h7-v/DIYnamount/data/sm57transcrop.png

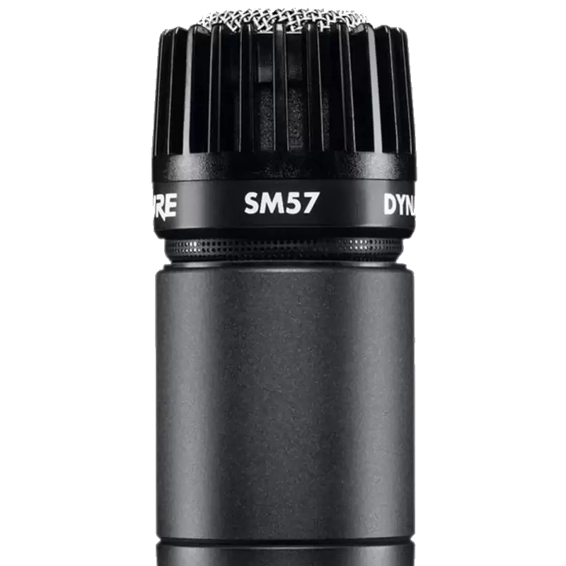
data/sm57transcrop.png
