h7-v/DIYnamount/data/vintage30.png

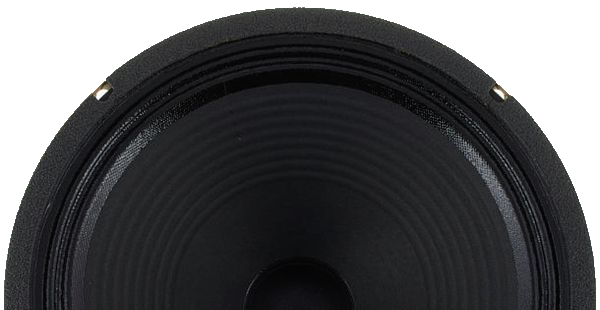
data/vintage30.png
