h7-v/DIYnamount/(threads)

Thread 1 (2025-06-06):

One of the axis doesn't move

bcochofel, 2025-06-06:
Hi, first of all, I would like to thank you for this amazing project.
I've followed the guidelines and successfully replicated this project, but I'm experiencing a peculiar issue.

On the page, I'm able to click on the move left, move right, and move closer, and make the motors work, but when I press the move further, I hear a noise, I see on the serial monitor something happening, but the motor doesn't move.
I've tried switching motors and even the drivers, but still the issue happens. I also changed the starting point from 100 to 50 and the move further workers, but the move closer doesn't. I've also tried using just the motors without any structure to see if it could be something related to the current driving the motor, but the problem still happens. All good in the left and right movement, but not in the closer and further one.

Not sure if you can help me with this, or maybe you had some type of problem like this, but any help would be appreciated

Thanks,
Bruno

h7-v, 2025-06-08:
Hi Bruno,
Thanks for checking it out and having a go! The only issue that I encountered when building one the first time round was tightening the timing gear too close to the motor which kind of locked and jammed it in place. After adjusting that I was fine. That obviously doesn't sound like your problem however.

Both motors move based on the exactly same code, albeit their starting positions in software are different. One other person who built this seems to have had a similar issue to you, although they didn't press further after mentioning it leading me to believe they might have solved it? I'll send them a message.

If the starting position of the mic is at its closest to the speaker, your first statement about pressing move further, hearing a noise but not seeing any movement points to move closer and further being physically flipped for your setup. I presume you've tried moving the mic starting position to somewhere in the middle between furthest and closest and then trying closer and further. In fact if you're saying that the issue persists even after removing the motors entirely then perhaps this is irrelevant.

Stepper motor drivers that have their DIR pins at a floating or indeterminate voltage can apparently lead to mechanical noise when the step pin is triggered (although I don't have my stand here to test at home). Sort of like they're trying to move but they don't really know in which direction, and although you also say that you've tried switching the drivers to no avail, have you tried switching GPIO pins coming from the ESP32? Trusting you've triple checked all your wiring, if switching the drivers on your breadboard etc leads to the same issue regardless of which driver, that may point to a GPIO issue on the ESP32.

I wish this was a software issue that I could just fix and you'd be on your way but I'm convinced it's either a hardware issue, or there's something about the ESP32 dev board that you and this other person are using that doesn't quite line up with what I built this with. There are lots of different variations of these boards out there from a whole bunch of different manufacturers and perhaps I ended up with some super niche board or something.

Let me know how you get on with trying some different GPIO pins, and I'll try and respond asap. It would be really good to have this solved!

h7

bcochofel, 2025-06-08:
Hi, thanks for the quick answer. I've tried most of the things you mentioned, but I haven't tried using another GPIO. Will do that and let you know.

Thanks,
Bruno

bcochofel, 2025-06-08:
Hi, quick update, just changed the ESP32 and it's working :-)

Thank you for the help, it was probably something regarding GPIO, as you said.

Bruno

Closed 2025-06-08.
