h7-v/DIYnamount/images/esp32.JPG

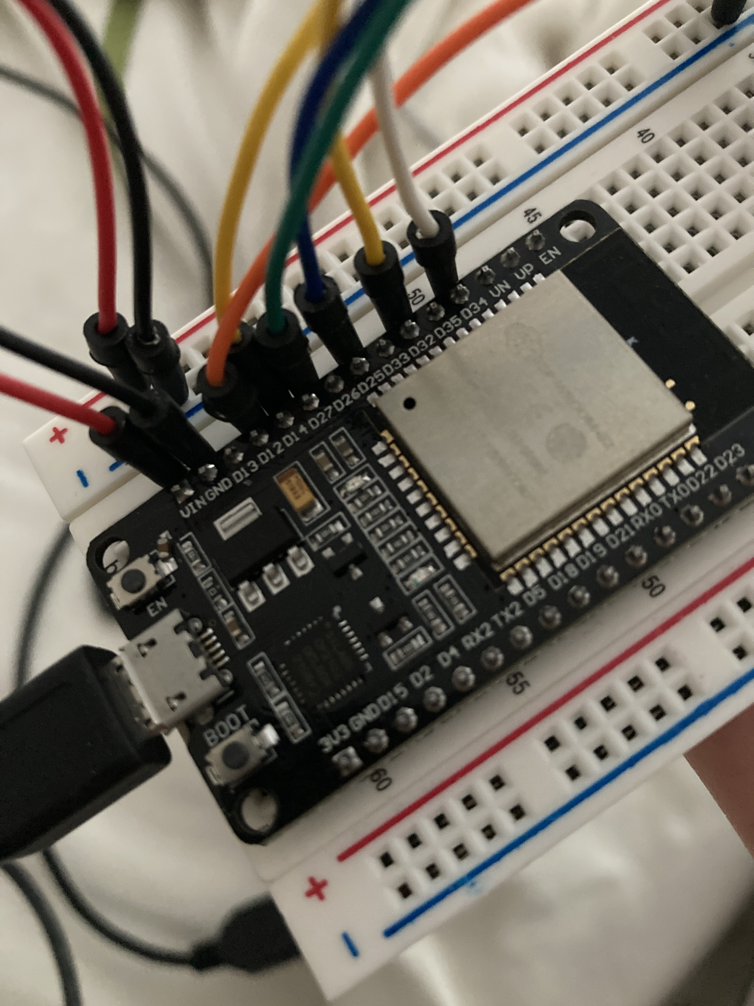
[picture p2: images/esp32.JPG]
images/esp32.JPG
